jwilcox99/Walkie_Project/README.md

Repository for collaboration, notes, and resources surrounding our Walkie Talkie Project.
