jwilcox99/Walkie_Project/case_designs/MK1/CXS-1_MK1.stl

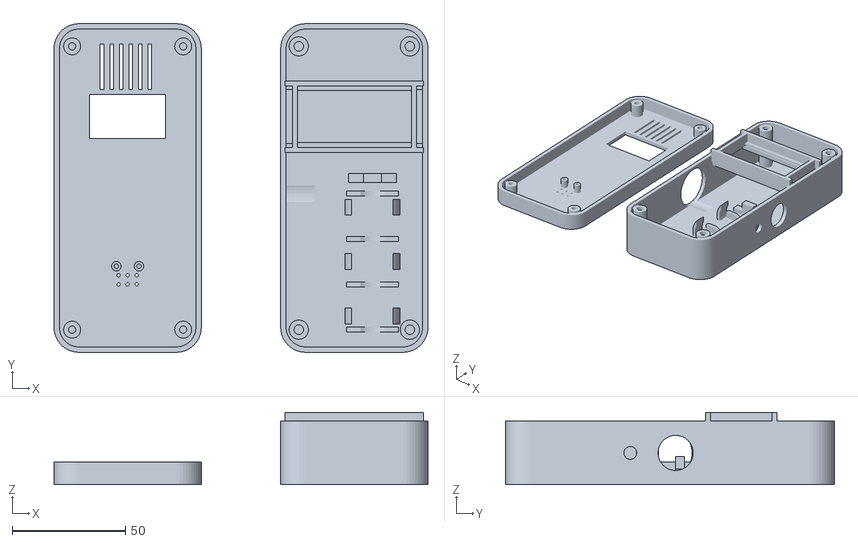
[picture p1: CAD file, 2026-06-30]
case_designs/MK1/CXS-1_MK1.stl
165.0 x 145.0 x 31.9
