jwilcox99/Walkie_Project/case_designs/MK1/MK1.1/CXS-1_MK1_1.stl

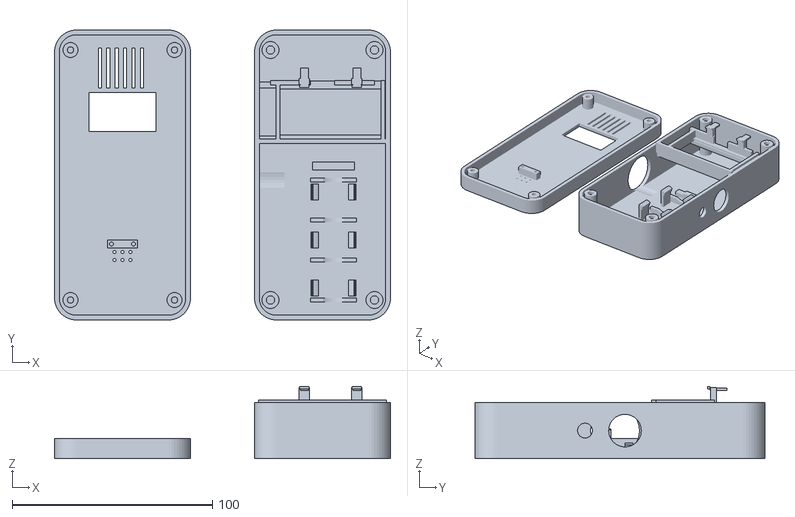
[picture p2: CAD file, 2026-07-02]
case_designs/MK1/MK1.1/CXS-1_MK1_1.stl
168.0 x 145.0 x 36.1
