jwilcox99/Walkie_Project/case_designs/MK0/cxs_walkie_mk0_v7.3mf

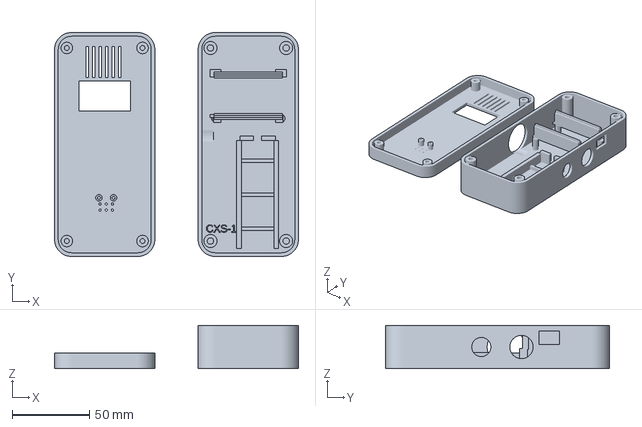
[picture p3: CAD file, 2026-06-30, an earlier design]
case_designs/MK0/cxs_walkie_mk0_v7.3mf
158.0 x 145.0 x 28.0 mm
