jwilcox99/Walkie_Project/(list of files, cad)

Other CAD files:
case_designs/MK1/MK1.1/CXS-1_MK1_1.scad
case_designs/MK0/cxs_walkie_mk0.scad
case_designs/MK0/cxs_walkie_mk0_v7.scad
case_designs/MK0/cxs_walkie_mk0_v7.stl
case_designs/MK0/cxs_walkie_params.scad
case_designs/MK0/cxs_walkie_params_v5.scad
case_designs/MK1/02_heltec_mount.scad
case_designs/MK1/03_battery_holder.scad
case_designs/MK1/05_audio.scad
case_designs/MK1/cxs_params.scad
