jwilcox99/Walkie_Project/Schematics/walkie-talkies.kicad_pcb

## KiCad design Schematics/walkie-talkies.kicad_pcb (2026-07-02)

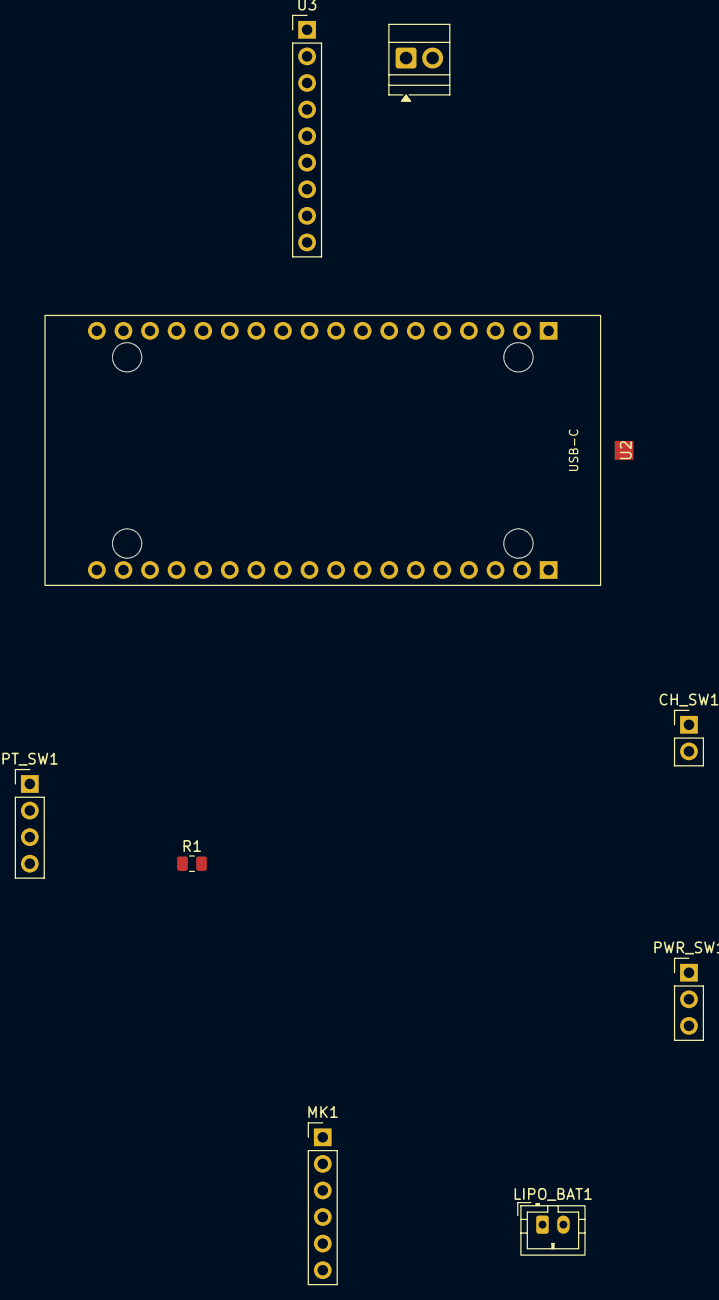
[picture p4: board walkie-talkies.kicad_pcb from above]

Board: 2 copper layers, 9 parts (0 on the bottom side), 15 nets, no tracks yet.

Parts:
CH_SW1: SW_Push; PinHeader_1x02_P2.54mm_Vertical
LIPO_BAT1: Battery_Cell; JST_PH_B2B-PH-K_1x02_P2.00mm_Vertical
LS1: Speaker; TerminalBlock_Xinya_XY308-2.54-2P_1x02_P2.54mm_Horizontal
MK1: Adafruit_ICS43434_Breakout; PinHeader_1x06_P2.54mm_Vertical
PT_SW1: SW_Push_LED; PinHeader_1x04_P2.54mm_Vertical
PWR_SW1: SW_SPDT; PinHeader_1x03_P2.54mm_Vertical
R1: 1k ohm; R_0805_2012Metric
U2: Heltec_WiFi_LoRa_32_V4_Socket_SymbolNumbered
U3: Adafruit_MAX98357A_Breakout; PinHeader_1x09_P2.54mm_Vertical

Connections:
/CH_SW: CH_SW1.1, U2.5 (GPIO5)
/I2S_BCLK: MK1.4 (BCLK), U3.6 (BCLK)
/I2S_MIC_DATA: MK1.6 (DOUT), U2.33 (GPIO33)
/I2S_SPK_DATA: U2.34 (GPIO34), U3.5 (DIN)
/I2S_WS: MK1.5 (LRCL), U3.7 (LRC)
/NO_CONNECT: PWR_SW1.3 (C), U3.4 (GAIN)
/PTT_LED: PT_SW1.3 (K), U2.6 (GPIO6)
/PTT_SW: PT_SW1.1, U2.4 (GPIO4)
/PWR_SW: PWR_SW1.2 (B), U2.7 (GPIO7)
/VBAT: LIPO_BAT1.1 (+), U2.VBAT
/VE: MK1.1 (3V), R1.1, U2.VE, U3.1 (VDD), U3.3 (SD_MODE)
GND: CH_SW1.2, LIPO_BAT1.2 (-), MK1.2 (GND), MK1.3 (SEL), PT_SW1.2, PWR_SW1.1 (A), U2.GND, U3.2 (GND)
unnamed: PT_SW1.4 (A), R1.2
unnamed: LS1.2, U3.8 (VO+)
unnamed: LS1.1, U3.9 (VO-)
