jwilcox99/Walkie_Project/Scripts/Arduino/Firmware/CXS_Walkie_v0_3_2/CXS_Walkie_v0_3_2.ino

#include "config.h"
#include "types.h"
#include "audio.h"
#include "display_ui.h"
#include "radio_local.h"
#include "buttons.h"
#include "power.h"
#include "settings.h"
#include "state_manager.h"
#include "wifi_manager.h"
#include "remote_relay.h"

WalkieState state;

void setup() {
  Serial.begin(115200);
  delay(1000);

  Serial.println("0. Boot");

  state.config.mode = MODE_LOCAL;
  state.config.talkGroup = 1;

  state.runtime.status = "Booting";
  state.runtime.txPackets = 0;
  state.runtime.rxPackets = 0;
  state.runtime.lastRxMs = 0;
  state.runtime.transmitting = false;
  state.runtime.receiving = false;
  state.runtime.wifiConnected = false;
  state.runtime.wifiRSSI = 0;
  state.runtime.wifiIP = "-";

  setupSettings();
  loadSettings(state);

  setupPowerPins();
  setupButtons();
  setupWifiManager();
  setupRemoteRelay();

  enableVE();
  setupDisplay();
  showStartupScreen();

  setupSpeaker();
  setupLocalRadio();

  state.runtime.status = "Ready";
  drawMainScreen(state);
}

void loop() {
  static uint32_t lastScreenMs = 0;

  handlePower(state);
  handleFunctionButton(state);
  handlePTT(state);
  
  wifiManagerLoop(state);

  saveSettingsIfDirty(state);

  remoteRelayLoop(state);

  if (state.config.mode == MODE_LOCAL) {
    localRadioLoop(state);
  }

  if (millis() - lastScreenMs > 200) {
    drawMainScreen(state);
    lastScreenMs = millis();
  }
}
