jwilcox99/Walkie_Project/Scripts/Arduino/Firmware/CXS_Walkie_v0_3_2/remote_relay.h

#pragma once

#include "types.h"

void setupRemoteRelay();

void remoteRelayLoop(WalkieState &state);

bool relayConnected();
String relayStatus();

void remoteRelayPttStart(WalkieState &state);
void remoteRelayPttStop(WalkieState &state);
