jwilcox99/Walkie_Project/Scripts/Arduino/Firmware/CXS_Walkie_v0_3_2/wifi_manager.h

#pragma once

#include "types.h"

void setupWifiManager();

void connectWifi(WalkieState &state);
void disconnectWifi(WalkieState &state);

bool wifiConnected();
String wifiIpAddress();
int wifiSignalDbm();

void wifiManagerLoop(WalkieState &state);
