jwilcox99/Walkie_Project/Scripts/Arduino/Firmware/CXS_Walkie_v0_3_2/audio.h

#pragma once

#include "types.h"

void enableVE();
void disableVE();

void setupMic();
void setupSpeaker();
void stopI2S();

void readMicPacket(AudioPacket &packet);
void playAudioPacket(const AudioPacket &packet);
