jwilcox99/Walkie_Project/Scripts/Arduino/Firmware/CXS_Walkie_v0_3_2/settings.h

#pragma once

#include "types.h"

void setupSettings();

void loadSettings(WalkieState &state);
void saveSettingsNow(const WalkieState &state);

void markSettingsDirty();
void saveSettingsIfDirty(const WalkieState &state);

void resetSettings();
