jwilcox99/Walkie_Project/(commit log)

2026-07-10 V0.3
    relay ping working
2026-07-10 v0.3.1
    successfully sending binary packets via websocket relay
2026-07-10 v0.3.2 live audio
    sends and receive live audio between devices via internet relay
